tinkerer42/tami-cnc-ess-bob/README.md

# tami-cnc-ess-bob
Custom Breakout Board design for the Ethernet SmoothStepper (ESS). It will be used in the TAMI hackerspace CNC project.
