tinkerer42/tami-cnc-ess-bob/3D Models/c-1393788-2-a-3d.stp

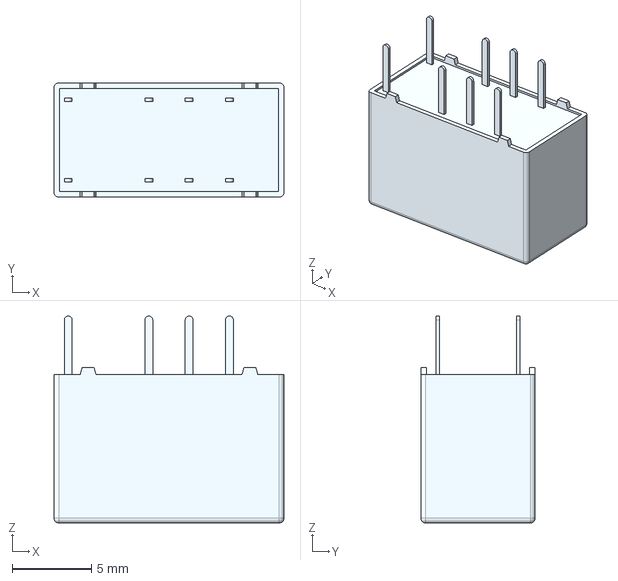
[picture p1: CAD file, 2018-09-04]
3D Models/c-1393788-2-a-3d.stp
14.5 x 7.20 x 13.1 mm
