tinkerer42/tami-cnc-ess-bob/3D Models/CircuitWorks-ELECTROLITIC CAPACITOR RADIAL 8X12.step

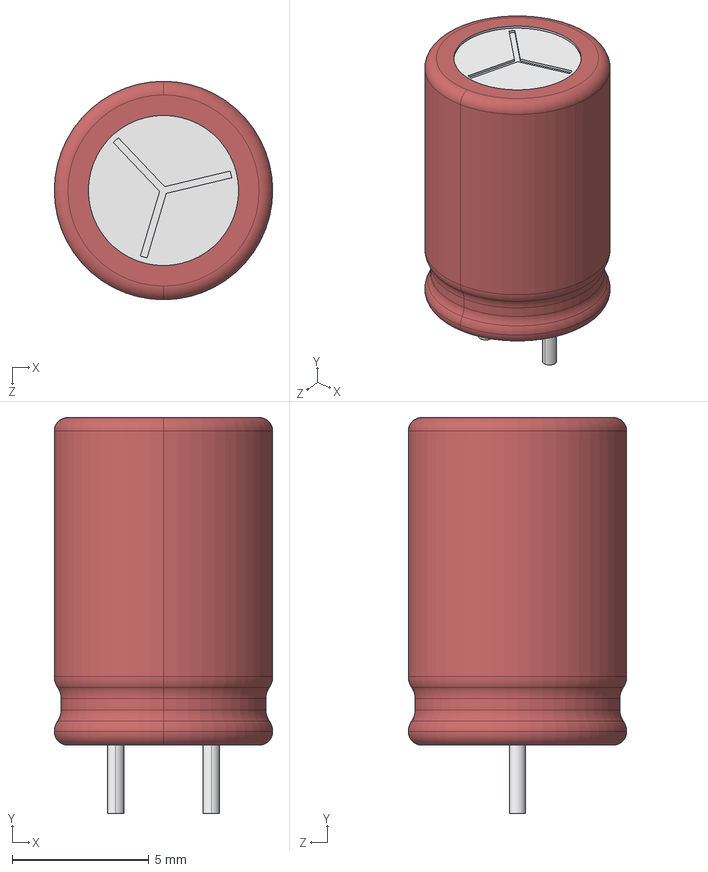
[picture p2: CAD file, 2018-08-14]
3D Models/CircuitWorks-ELECTROLITIC CAPACITOR RADIAL 8X12.step
8.00 x 14.5 x 8.00 mm
