tinkerer42/tami-cnc-ess-bob/3D Models/SOIC127P600X175-16.step

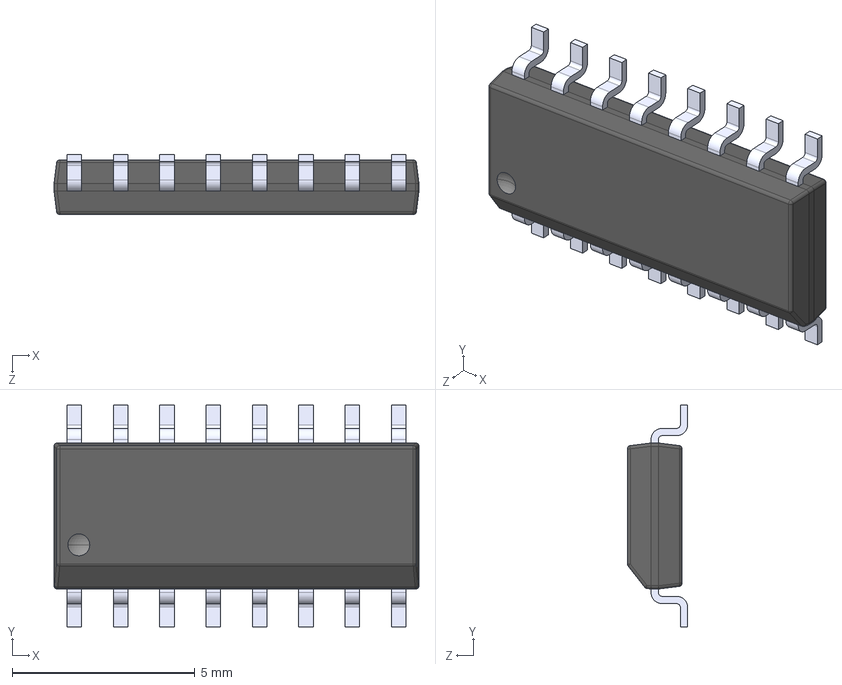
[picture p3: CAD file, 2018-08-08]
3D Models/SOIC127P600X175-16.step
10.0 x 6.08 x 1.65 mm
