tinkerer42/tami-cnc-ess-bob/3D Models/SOIC-16-1.step

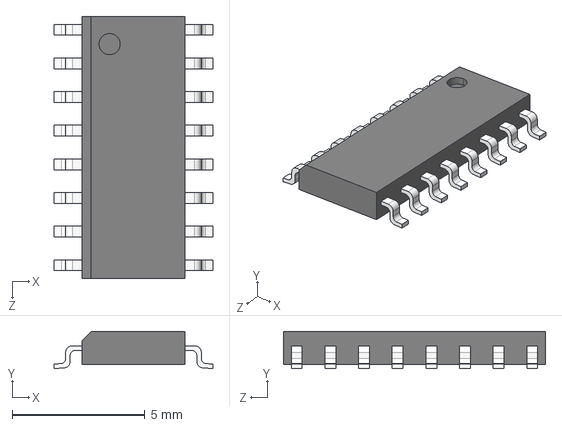
[picture p4: CAD file, 2018-08-08]
3D Models/SOIC-16-1.step
6.00 x 1.40 x 9.90 mm
