tinkerer42/tami-cnc-ess-bob/3D Models/ESQ-113-33-G-D.stp

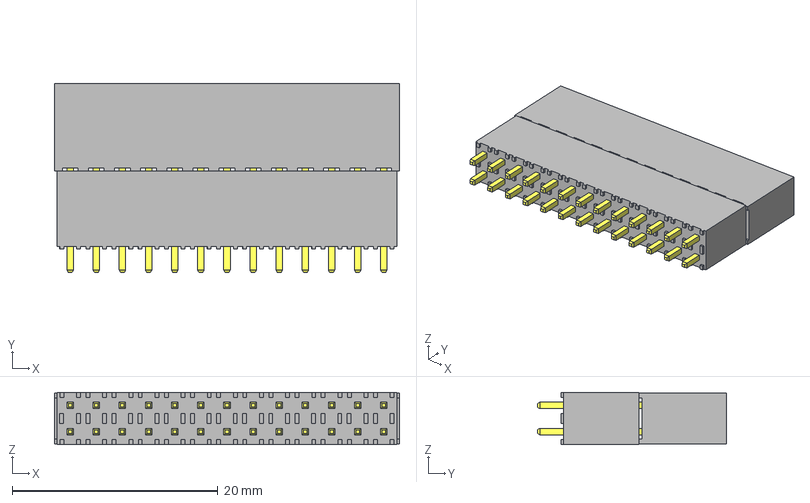
[picture p5: CAD file, 2018-08-07]
3D Models/ESQ-113-33-G-D.stp
33.5 x 18.4 x 5.08 mm
_ESQ-113-33-G-D_socket
_ESQ-113-33-G-D_pins
_ESQ-113-33-G-D-LL_bpins
