tinkerer42/tami-cnc-ess-bob/3D Models/395021003.stp

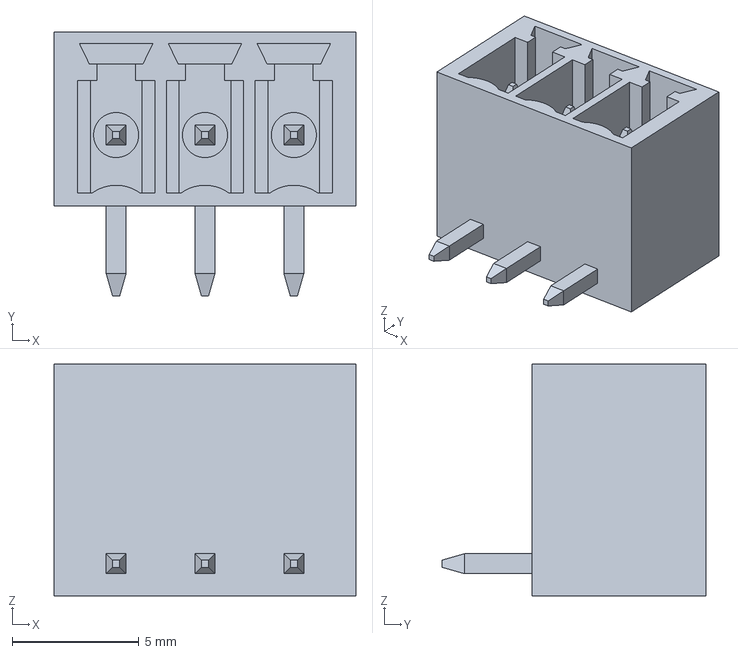
[picture p6: CAD file, 2018-09-13]
3D Models/395021003.stp
11.9 x 10.4 x 9.14 mm
