tinkerer42/tami-cnc-ess-bob/3D Models/395021010.stp

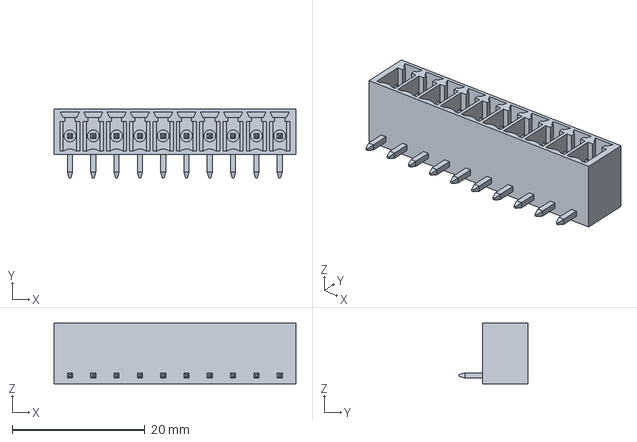
[picture p7: CAD file, 2018-09-13]
3D Models/395021010.stp
36.4 x 10.4 x 9.14 mm
