tinkerer42/tami-cnc-ess-bob/3D Models/395021008.stp

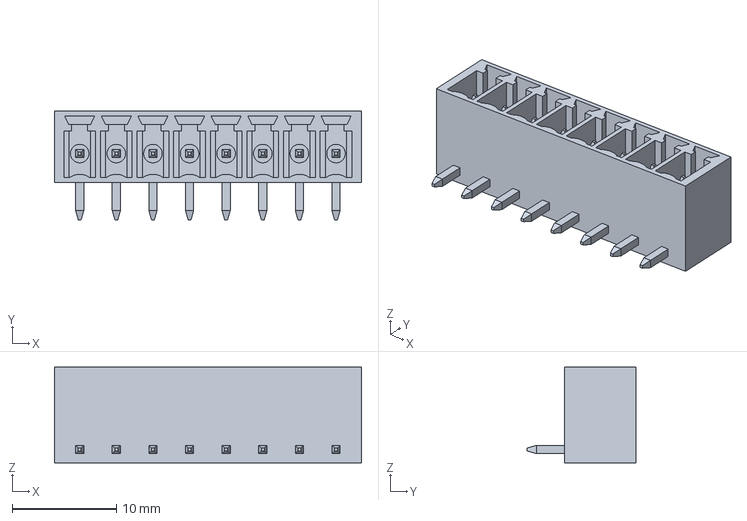
[picture p8: CAD file, 2018-09-13]
3D Models/395021008.stp
29.4 x 10.4 x 9.14 mm
