tinkerer42/tami-cnc-ess-bob/Outputs/TAMI CNC ESS-BoB v1.0 - Electrical Design Docs.PDF

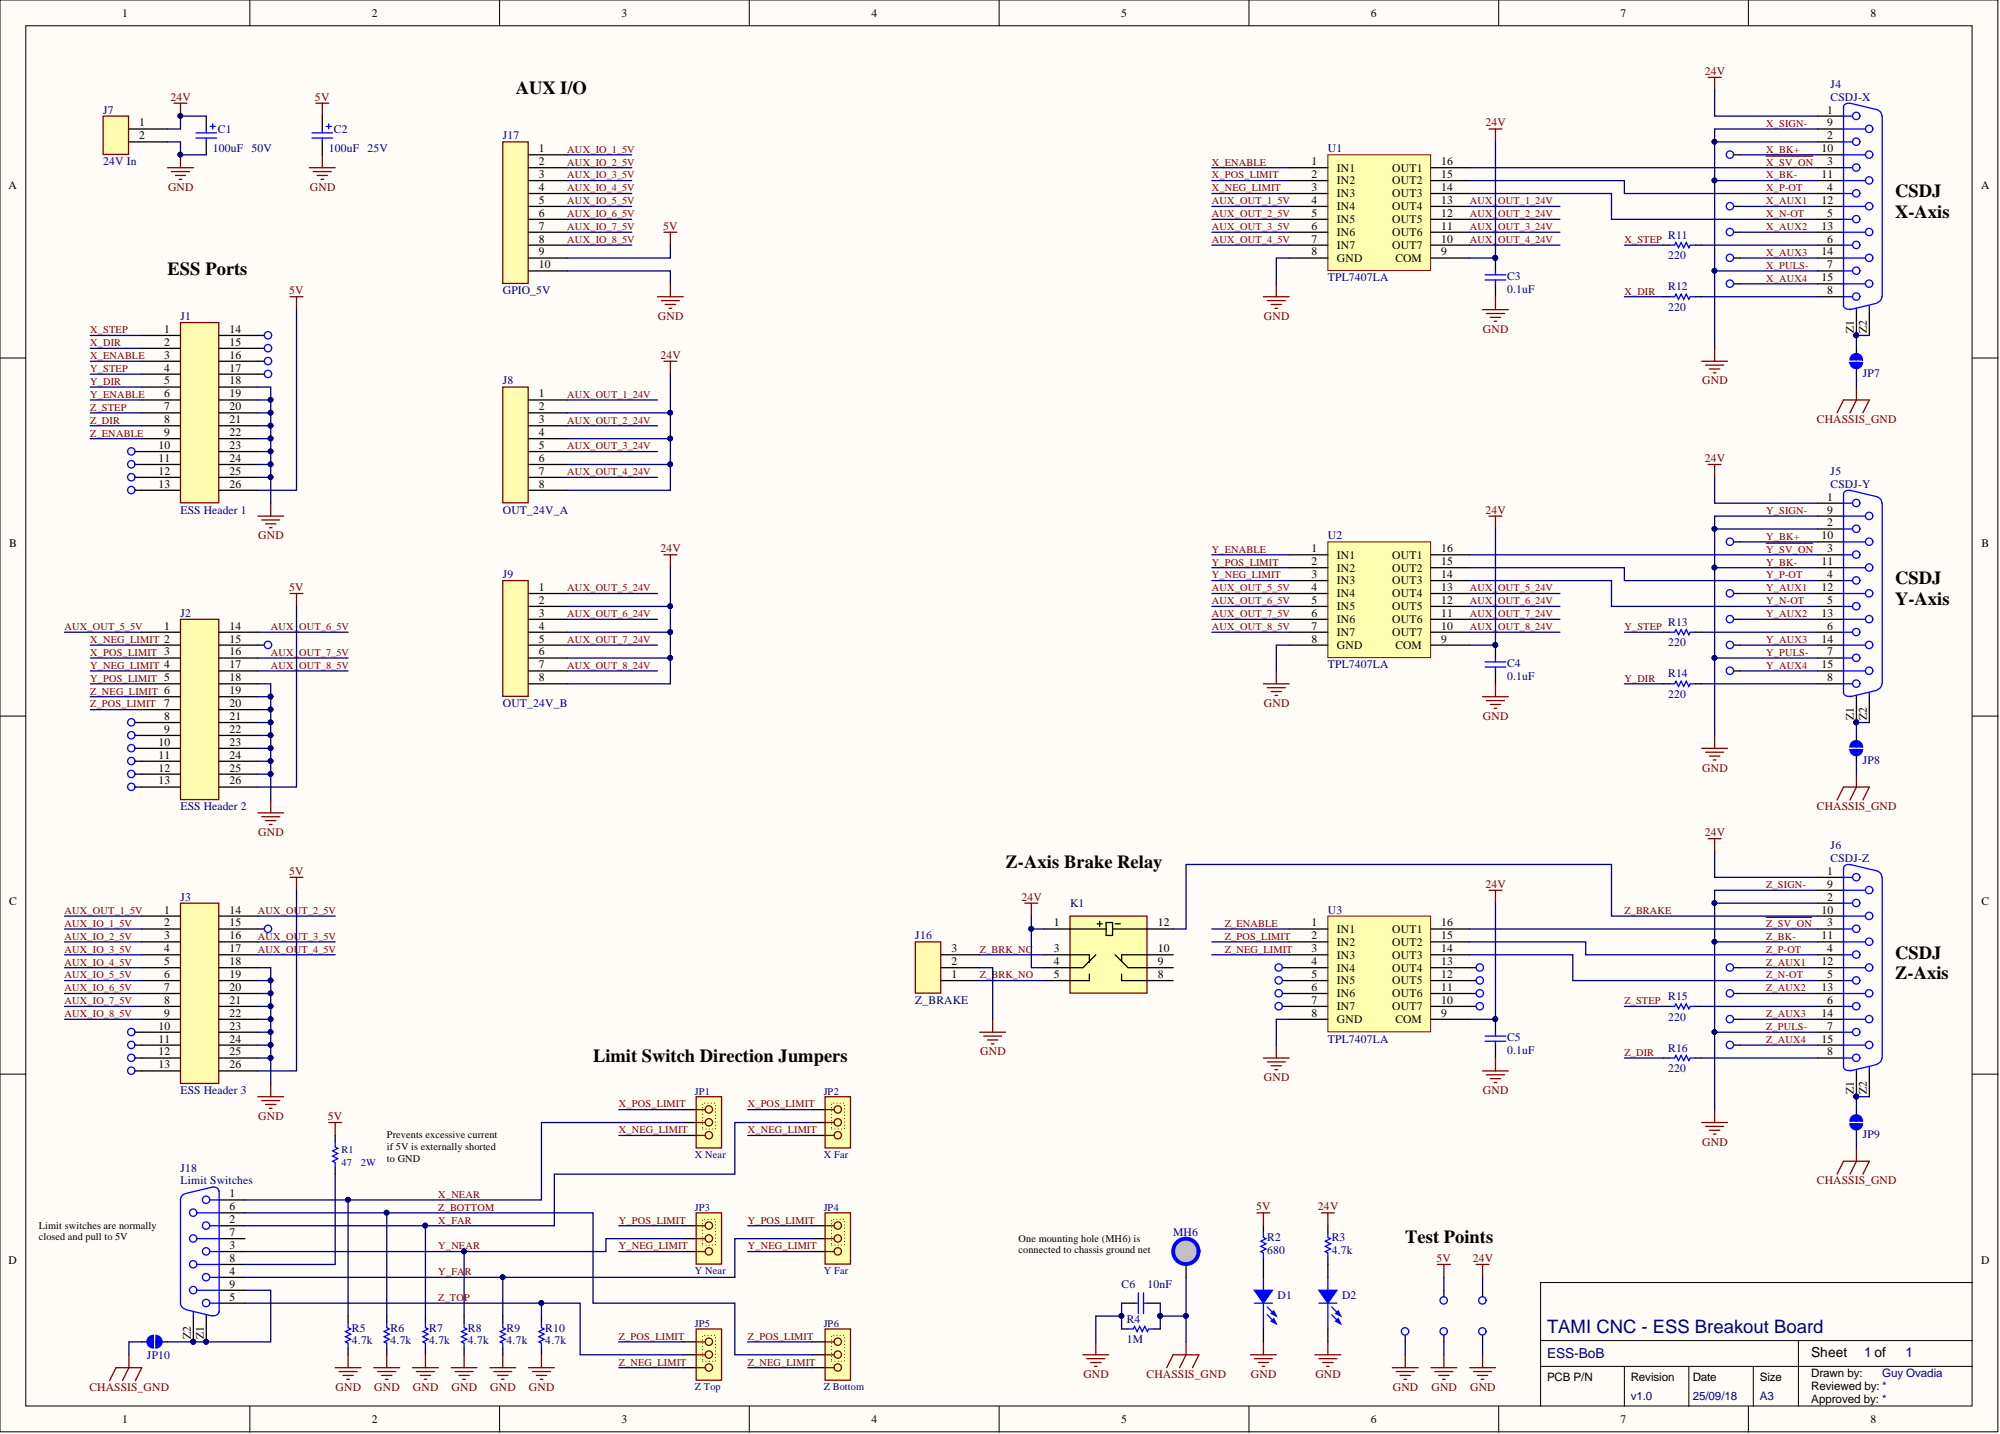
[picture p9: page 1]

1 4 | | | X_P-O T
1 3 1 2 | A U X_O | U T_1_24V U T_2_24V | X_A U X 1 X_N-O T | 1 2

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
Limit Switch Direction Jumpers

Z_BO T T O M
X_F A R

Y_N E A R | Y_N E G_LIMIT | | | Y_N E G_LIMIT r

R1 0 Z_P O S_LIMIT 4.7 k | J P 5

TAMI CNC - ESS Breakout BoardDrawn by

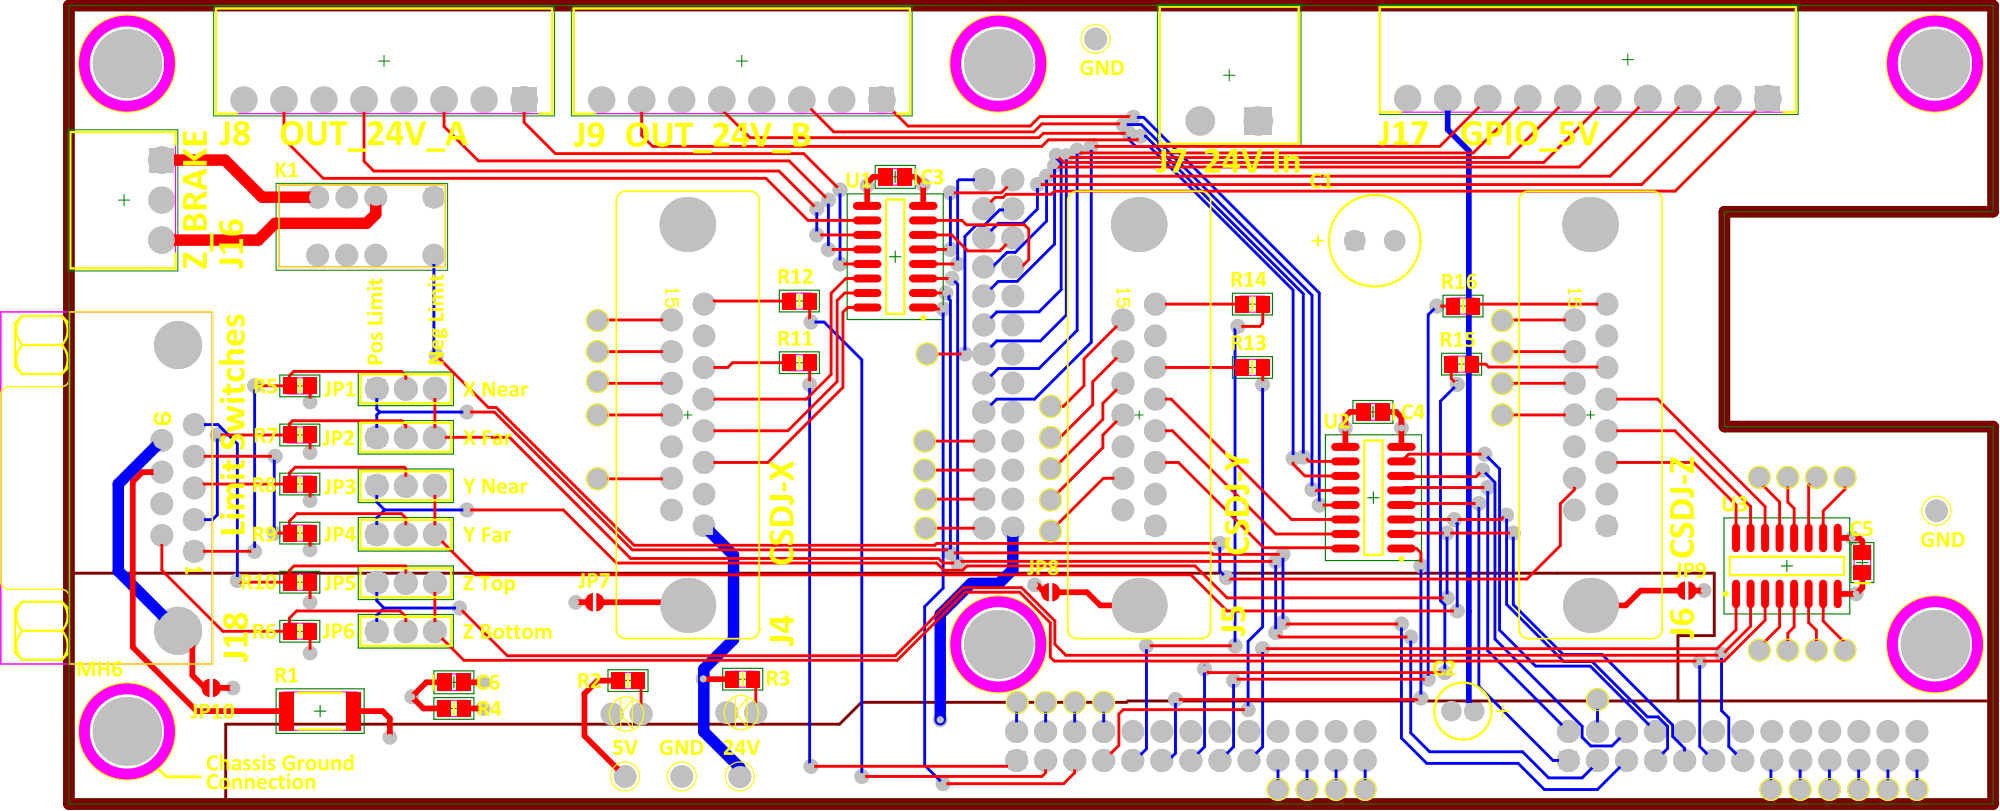
[picture p10: page 2]

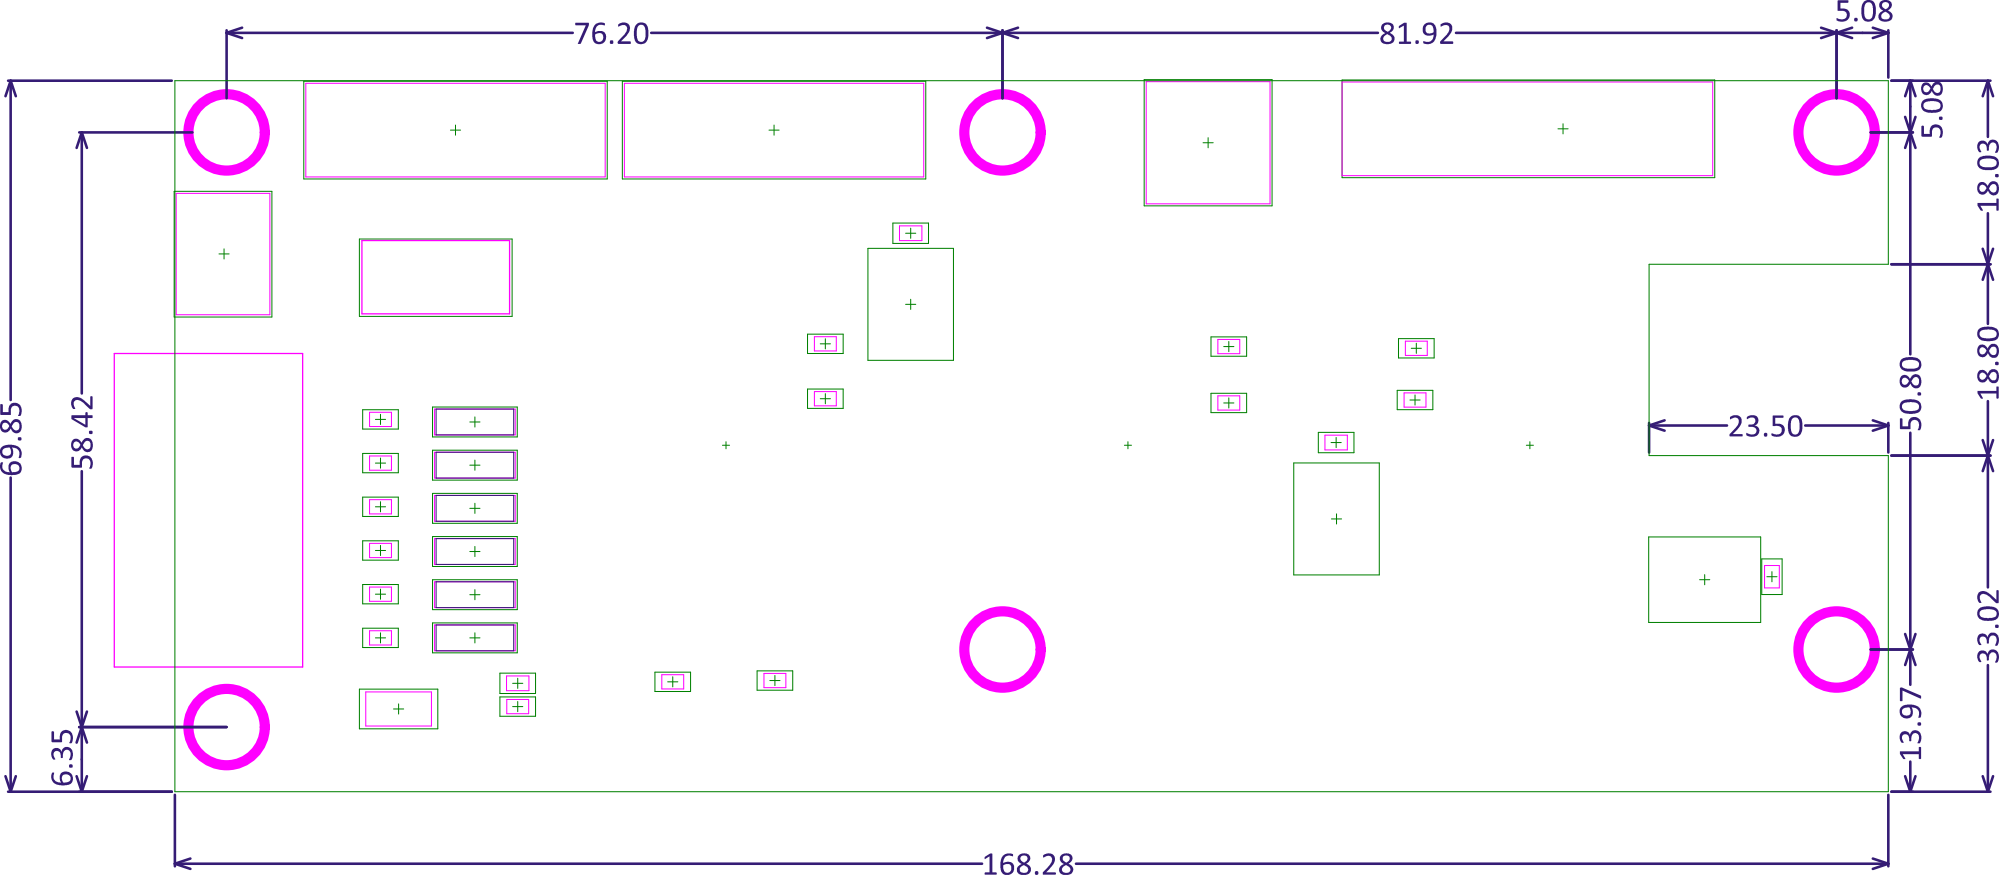
[picture p11: page 3]

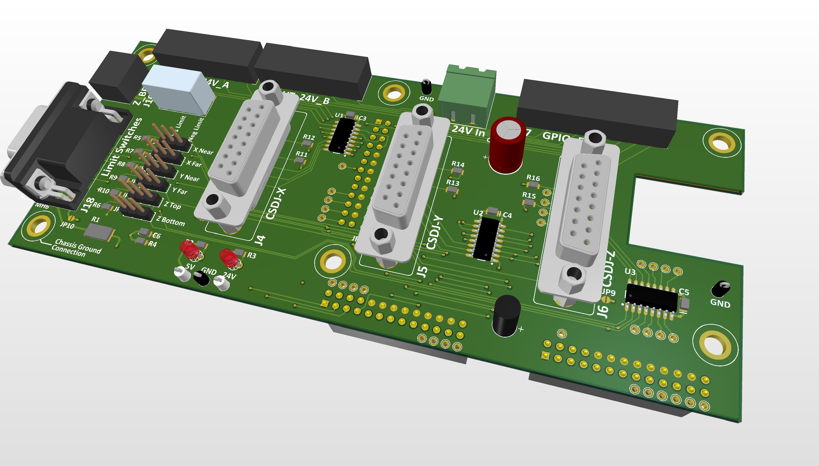
[picture p12: page 4]

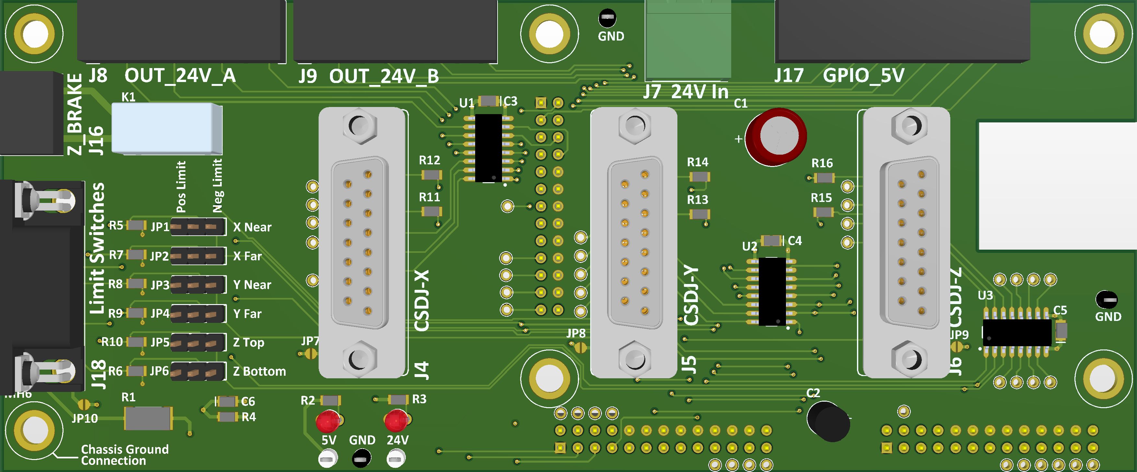
[picture p13: page 5]

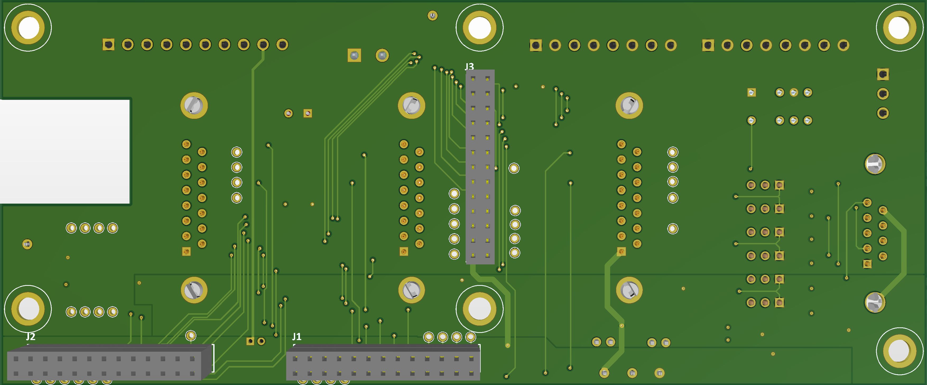
[picture p14: page 6]
