tinkerer42/tami-cnc-ess-bob/data from ESS Website/ESS_Rev0.pdf

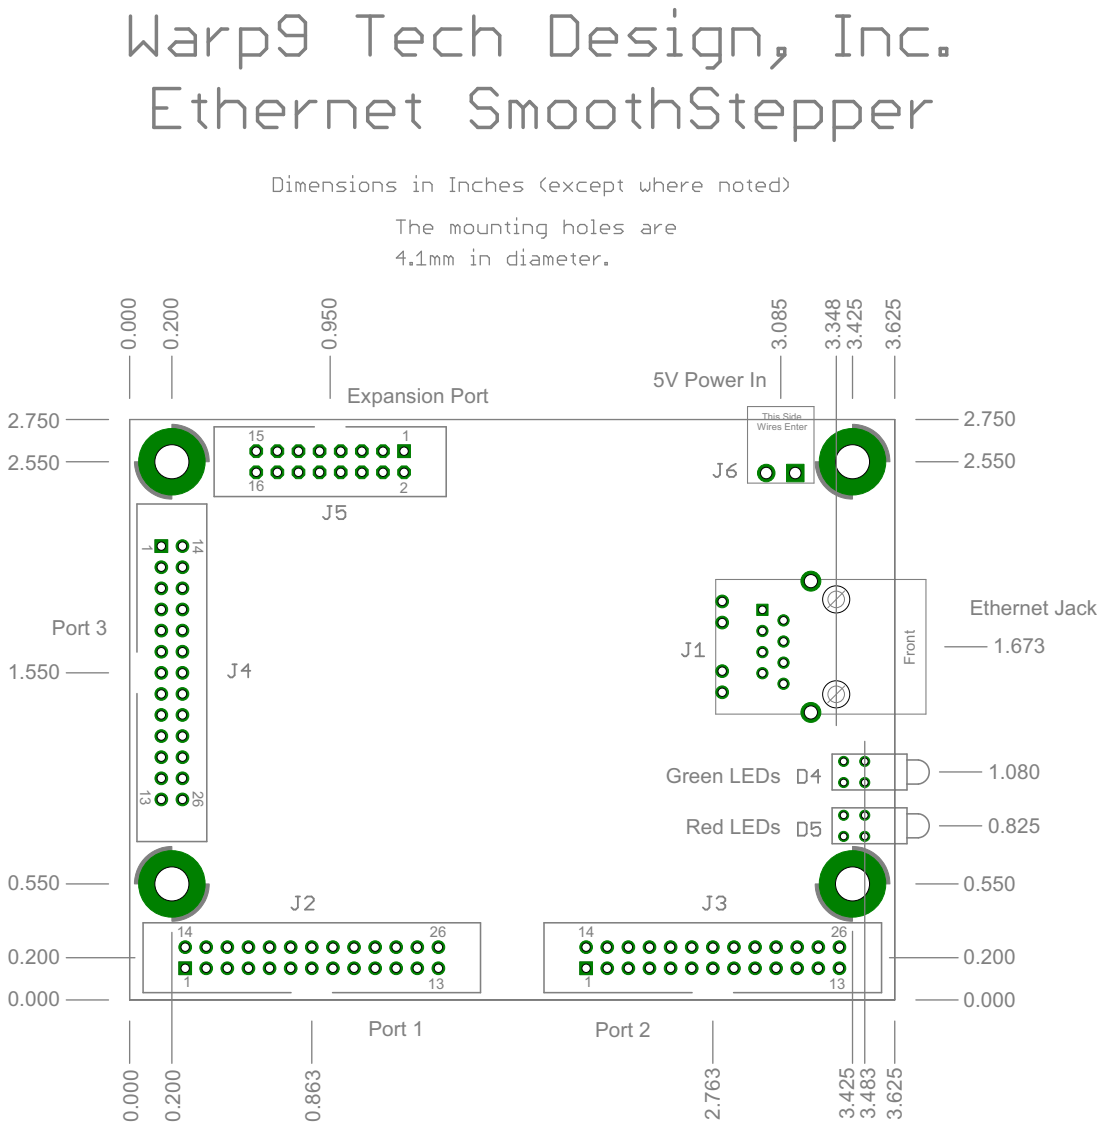
[picture p15: page 1]

This Side Wires Enter
