tinkerer42/tami-cnc-ess-bob/(list of files, drawings)

Other design files:
ESS-BoB.PcbDoc
ESS-BoB.SchDoc
TAMI CNC ESS-BoB.PrjPcb
