tinkerer42/tami-cnc-ess-bob/(commit log)

2018-08-07 Empty Altium project and schematic
    [ESS-BoB.SchDoc, TAMI CNC ESS-BoB.PrjPcb]
2018-08-07 move project to same folder as repo instead of sub-folder
    [ESS-BoB.SchDoc, TAMI CNC ESS-BoB.PrjPcb]
2018-08-07 data from ESS website added (in older Eagle format, needs conversion to Altium)
    [ESS_Rev0.brd, ESS_Rev0.sch]
2018-08-07 added 26 pin female headers to ESS
    [ESQ-113-33-G-D.stp, ESS-BoB.SchDoc]
2018-08-08 Schematics is WIP
    CSDJ interface is fairly complete; other stuff is mostly stubs.
    [ESS-BoB - CSDJ Interface.SchDoc, ESS-BoB - ESS Interface.SchDoc, ESS-BoB - Top Level.SchDoc, ESS-BoB.SchDoc, SOIC-16-1.step, SOIC127P600X175-16.step, TAMI CNC ESS-BoB.PrjPcb]
2018-08-11 Schematics continued
    [ESS-BoB - CSDJ Interface.SchDoc, ESS-BoB - Top Level.SchDoc]
2018-08-11 change to single sheet
    simpler, and the multi-channel feature isn't that important here.
    [ESS-BoB - CSDJ Interface.SchDoc, ESS-BoB - ESS Interface.SchDoc, ESS-BoB - Top Level.SchDoc, ESS-BoB.SchDoc, TAMI CNC ESS-BoB.PrjPcb]
2018-08-11 add TPL7407L parameters; label signals with axis prefix; clean up test points; other cleanups.
    [ESS-BoB.SchDoc, TAMI CNC ESS-BoB.PrjPcb]
2018-08-11 limit switch connector
    [ESS-BoB.SchDoc]
2018-08-14 24V connector added
    [ESS-BoB.SchDoc]
2018-08-14 decoupling and bulk capacitors added
    [CircuitWorks-ELECTROLITIC CAPACITOR RADIAL 8X12.step, ESS-BoB.SchDoc]
2018-08-14 limit switches wired (not to ESS yet); replaced ports with net labels.
    [ESS-BoB.SchDoc]
2018-09-03 limits, step, dir, enable connected to ESS headers
    [ESS-BoB.SchDoc]
2018-09-04 added brake relay; 24V aux outputs (for external relays); 5V aux I/O.
    [ESS-BoB.SchDoc]
2018-09-04 3D model of relay
    [c-1393788-2-a-3d.stp]
2018-09-04 cleanup; footprints fixed where needed.
    [ESS-BoB.SchDoc]
2018-09-04 replace TPL7407L with TPL7407LA
    the L version seems to be obsolete, the LA fixed an annoyance of requiring special care about OUT7.
    [ESS-BoB.SchDoc]
2018-09-04 fix wiring error in X_NEAR pulldown
    [ESS-BoB.SchDoc]
2018-09-04 added LEDs for 5V and 24V rails
    [ESS-BoB.SchDoc]
2018-09-04 annotate schematics (give designator numbers); fix net labels of CSDJ connectors
    [ESS-BoB.SchDoc]
2018-09-04 added template 2-layer PCB to project (empty for now)
    [ESS-BoB.PcbDoc, ESS-BoB.SchDoc, TAMI CNC ESS-BoB.PrjPcb]
2018-09-04 defined visible layers; added mounting holes per ESS
    [ESS-BoB.PcbDoc]
2018-09-04 transfered parts to PCB; located the 3 ESS connectors.
    [ESS-BoB.PcbDoc]
2018-09-04 about to place other connectors: board way too small! will need a balcony.
    [ESS-BoB.PcbDoc]
2018-09-07 changed D-Sub-15 to straight (was RA); added Output Generator; generated preliminary output PDF.
    [ESS-BoB.PcbDoc, ESS-BoB.SchDoc, TAMI CNC ESS-BoB.PrjPcb]
2018-09-11 fixed wiring error in J16
    [ESS-BoB.SchDoc, TAMI CNC ESS-BoB.PrjPcb]
2018-09-13 fixed some stuff found in DR
    - brake connection was incorrect.
    - AUX outputs (24V) needed 24V, not ground, next to each outut.
    - combine AUX outputs (24V) to 2 connectors (was 8 small ones) and use smaller pitch
    - smaller pitch also for 5V GPIO connector
    [395021008.stp, 395021010.stp, ESS-BoB.PcbDoc, ESS-BoB.SchDoc]
2018-09-13 fix from DR: add 220 Ohm resistors for STEP and DIR
    [ESS-BoB.PcbDoc, ESS-BoB.SchDoc]
2018-09-13 from DR: added cutout for ethernet connector
    this should allow using regular height headers for the ESS connectors, rather than special extra-tall ones.
    [ESS-BoB.PcbDoc]
2018-09-13 preliminary placement.
    [ESS-BoB.PcbDoc, ESS-BoB.SchDoc]
2018-09-13 replace Z-brake connector with smaller one; show connector labels.
    [395021003.stp, ESS-BoB.PcbDoc, ESS-BoB.SchDoc]
2018-09-13 replaced test pads with smaller ones
    [ESS-BoB.PcbDoc, ESS-BoB.SchDoc]
2018-09-13 added Custom ESS Breakout Board.docx
2018-09-22 larger font for connector designators; move CSDJ connector designators to a more visible location.
    [ESS-BoB.PcbDoc]
2018-09-22 added 2 more mounting holes
    [ESS-BoB.PcbDoc]
2018-09-22 jumpers: added comments on silkscreen, reordered them.
    [ESS-BoB.PcbDoc]
2018-09-22 some routing
    [ESS-BoB.PcbDoc]
2018-09-22 more routing
    [ESS-BoB.PcbDoc]
2018-09-22 all routing except power nets is done
    [ESS-BoB.PcbDoc, ESS-BoB.SchDoc]
2018-09-22 routed everything except chassis ground
2018-09-24 chassis ground is WIP; about to change to 4-layers board.
    [ESS-BoB.SchDoc]
2018-09-24 changed to 4-layer board; finished chassis-GND routing; DRC pass!
    [ESS-BoB.SchDoc]
2018-09-24 fixed mounting hole chassis-GND connection and marked on silkscreen
    [ESS-BoB.PcbDoc]
2018-09-24 wider tracks for Z-brake
    [ESS-BoB.PcbDoc]
2018-09-24 added dimensions; fixes to output generator
    [ESS-BoB.PcbDoc]
2018-09-24 2 more GND test points
    [ESS-BoB.SchDoc]
2018-09-24 MH6 mounting hole which connects to chassis explicitly added to schematic
    otherwise updating PCB from schematic just removes this connection to chassis-GND
    [ESS-BoB.SchDoc]
2018-09-24 final cleanup, generated gerbers, sent to production!
    [ESS-BoB.GBL, ESS-BoB.GBO, ESS-BoB.GBP, ESS-BoB.GBS, ESS-BoB.GTL, ESS-BoB.GTO, ESS-BoB.GTP, ESS-BoB.GTS]
